moca0511/lapis/pic/lapis.png

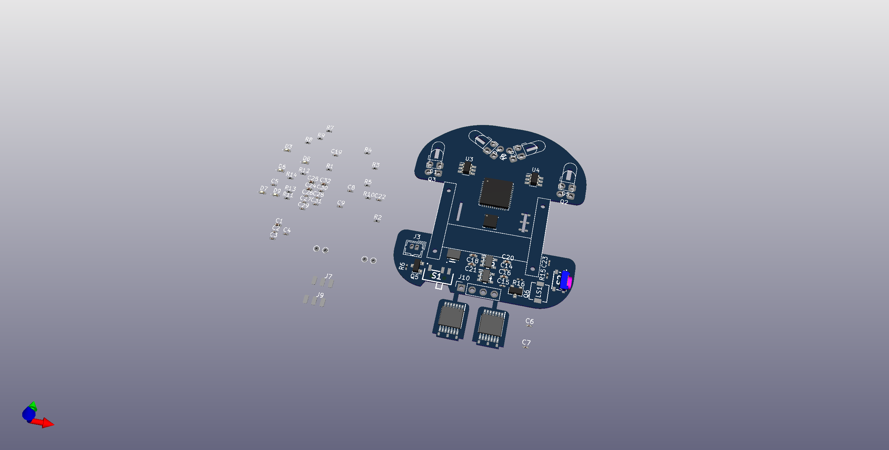
pic/lapis.png
