moca0511/lapis/pcb/lapis/lapis.jpg

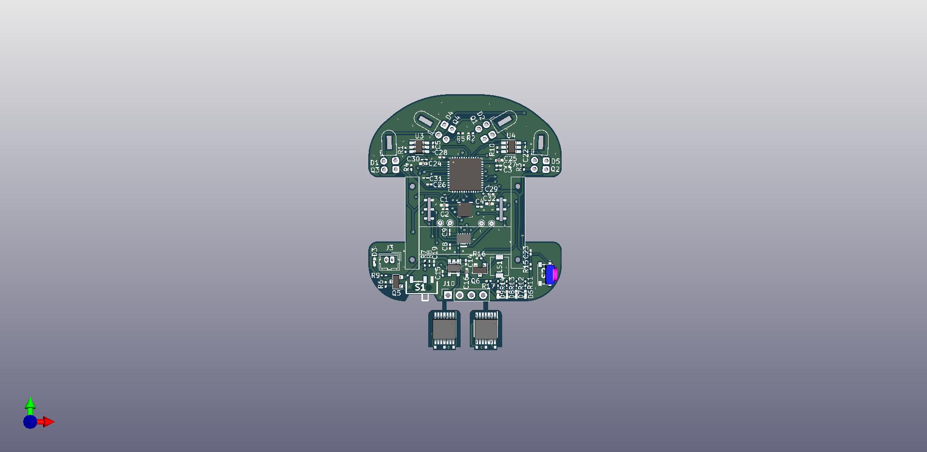
pcb/lapis/lapis.jpg
