moca0511/lapis/pic/3Dprint v1.png

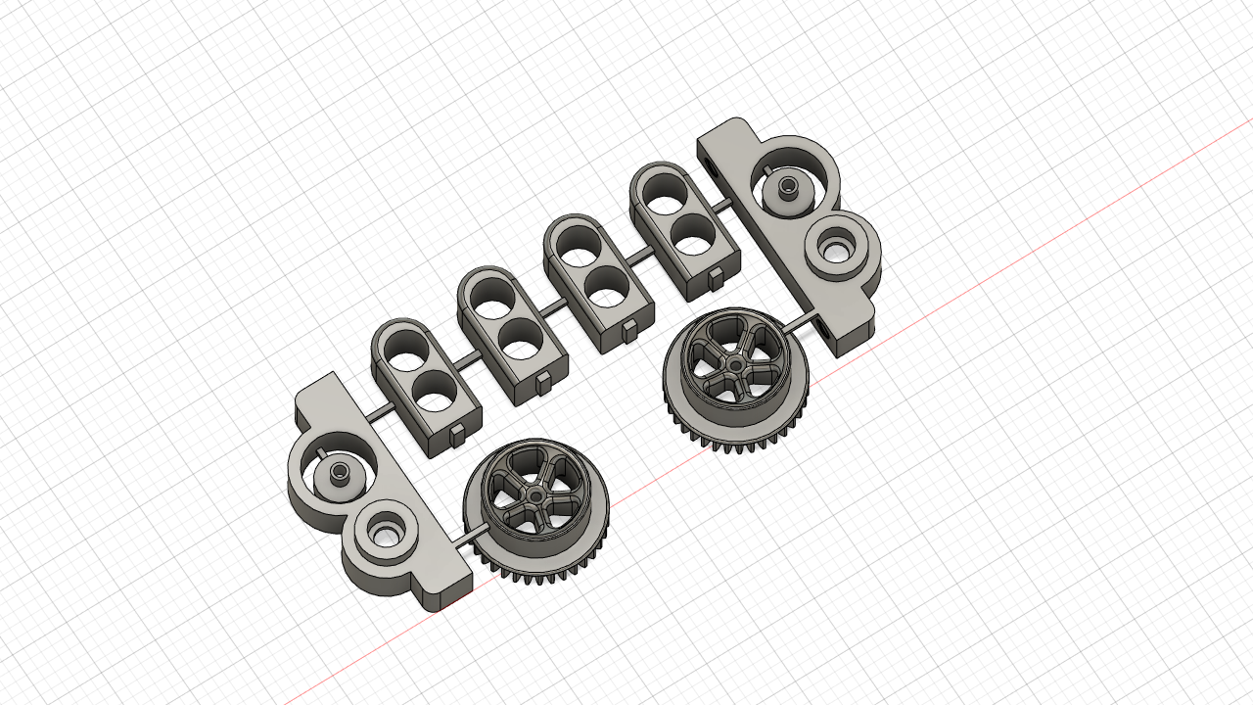
pic/3Dprint v1.png
