moca0511/lapis/pic/lapis v25.png

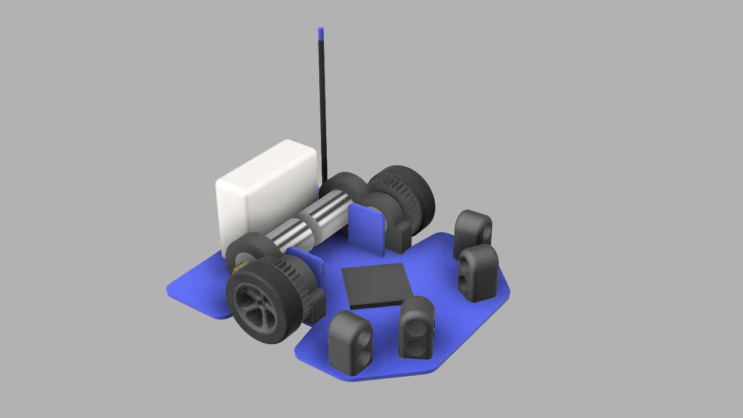
pic/lapis v25.png
