moca0511/lapis/pic/lapis v40.png

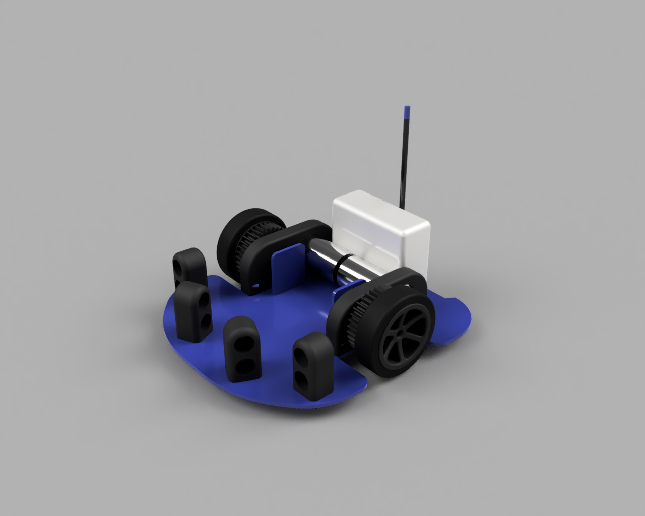
pic/lapis v40.png
