moca0511/lapis/pic/lapis_v30.PNG

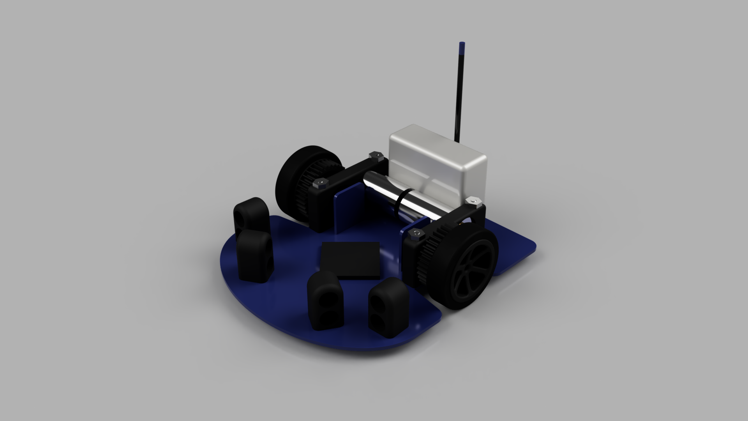
pic/lapis_v30.PNG
