moca0511/lapis/pic/mpu6500.png

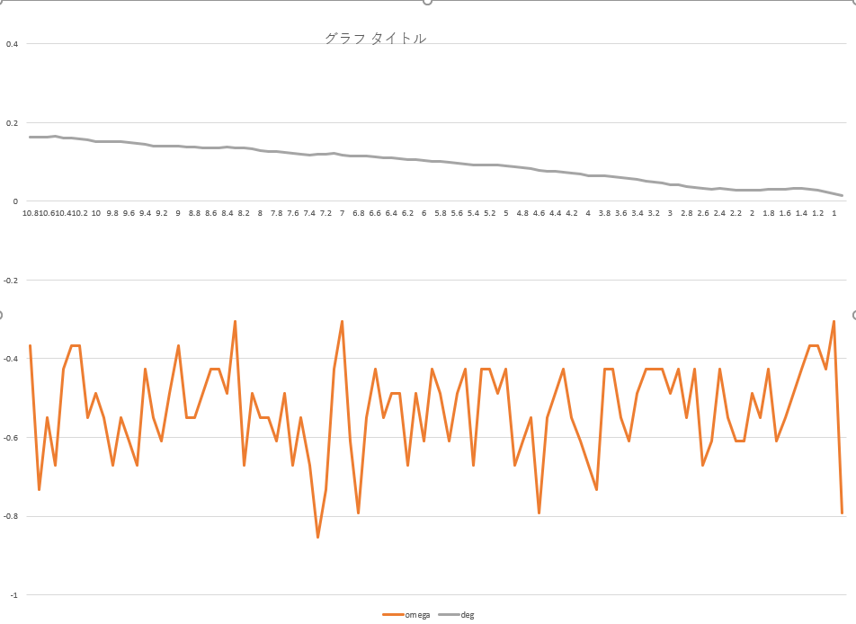
pic/mpu6500.png
