moca0511/lapis/pic/Sirius (v3~recovered).png

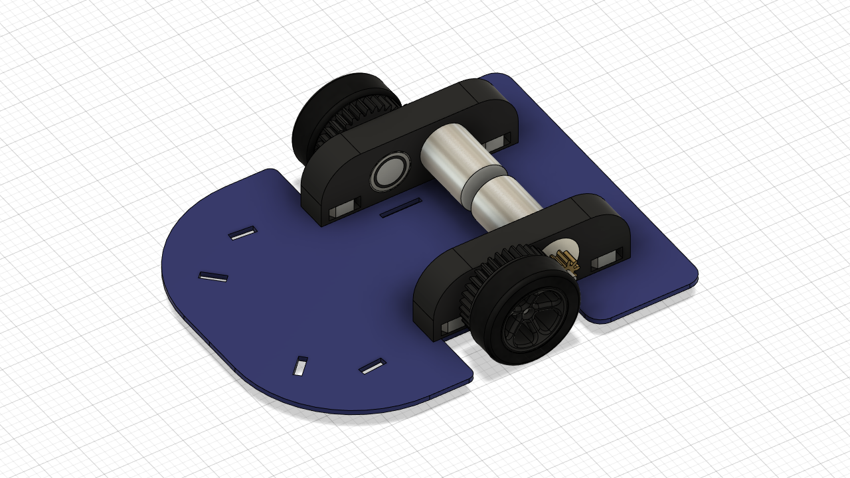
pic/Sirius (v3~recovered).png
