moca0511/lapis/pic/Sirius v7.png

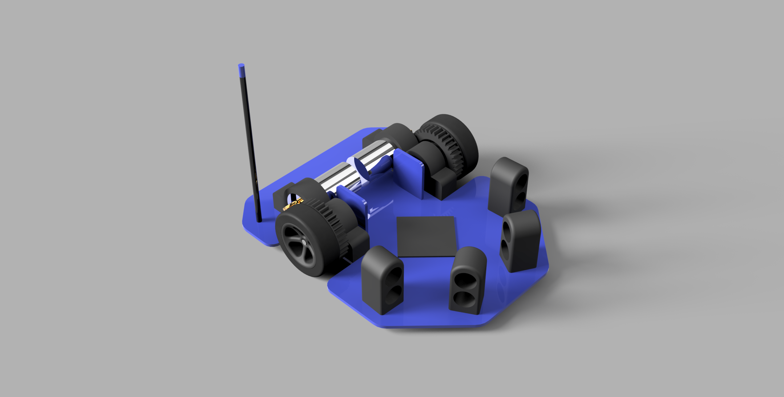
pic/Sirius v7.png
