moca0511/lapis/pic/Sirius v25.png

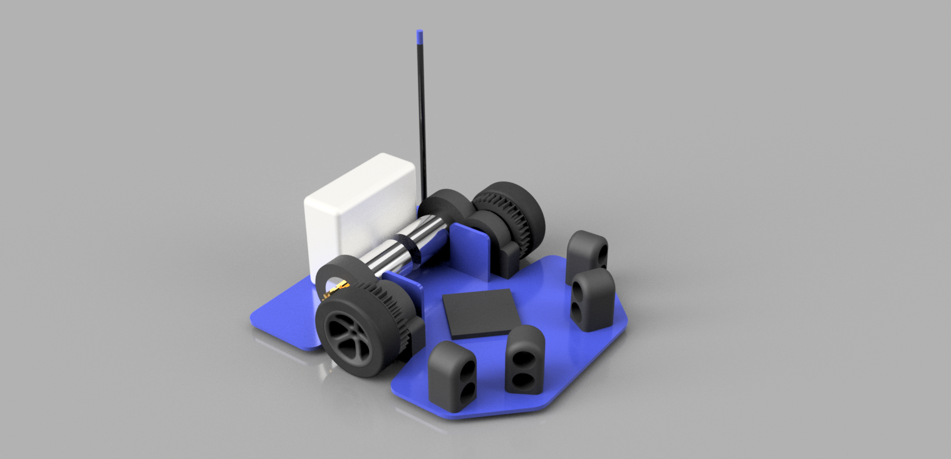
pic/Sirius v25.png
