moca0511/lapis/pic/Sirius v25_torimingu.png

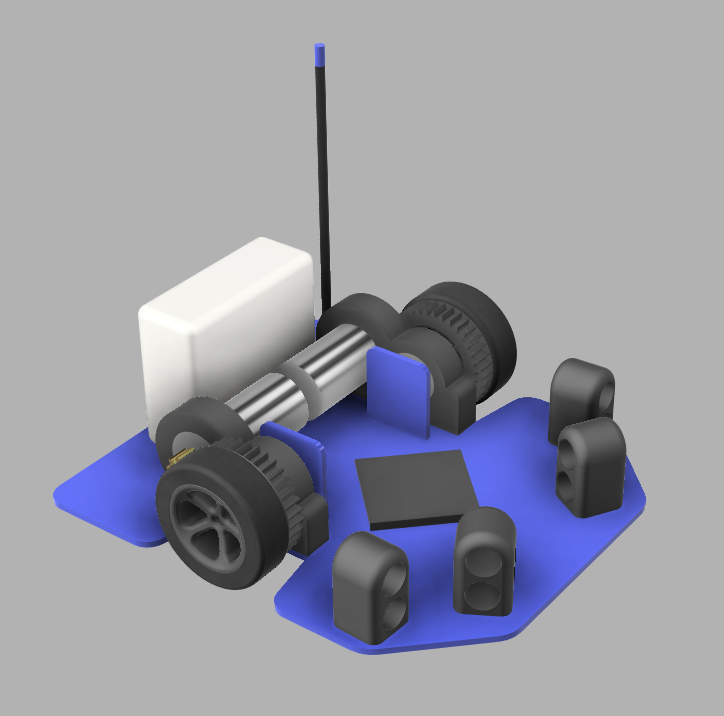
pic/Sirius v25_torimingu.png
