moca0511/lapis/pic/スクリーンショット 2021-02-08 151138.png

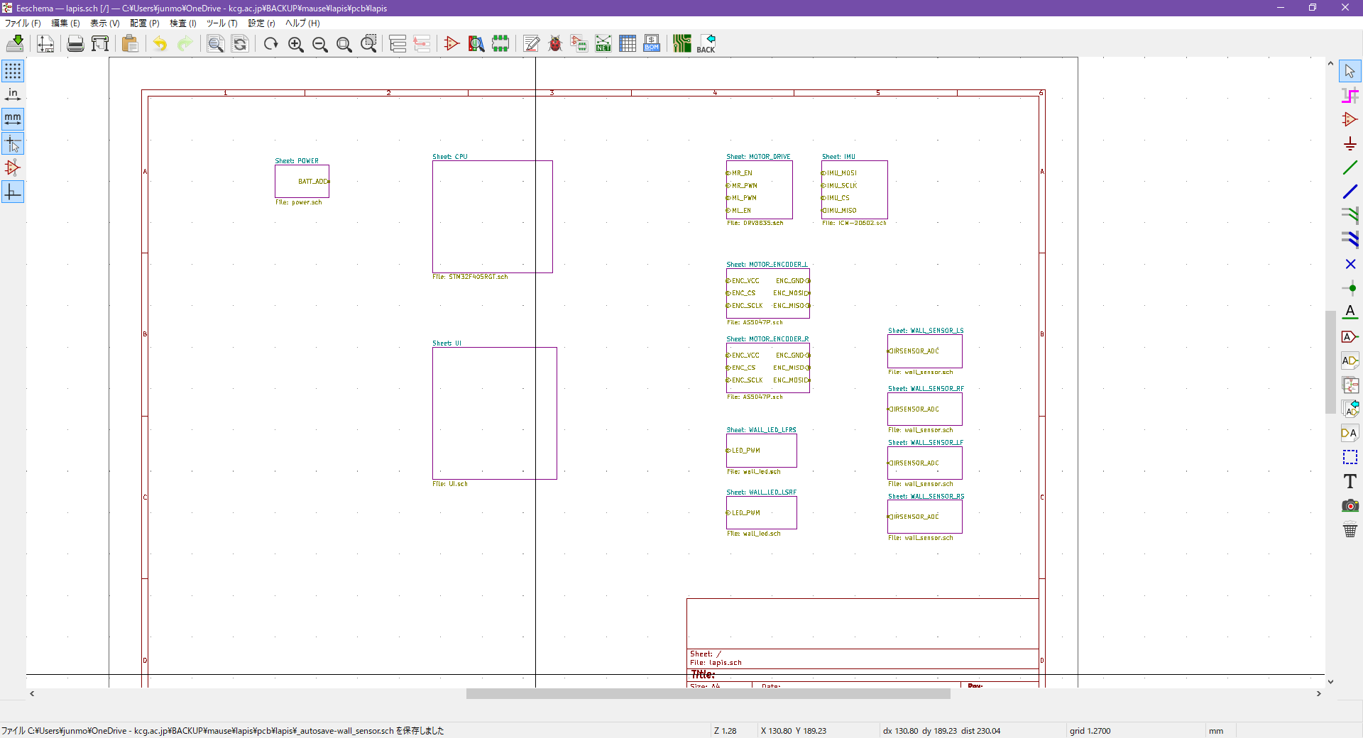
pic/スクリーンショット 2021-02-08 151138.png
