moca0511/lapis/pic/スクリーンショット 2021-06-03 014957.png

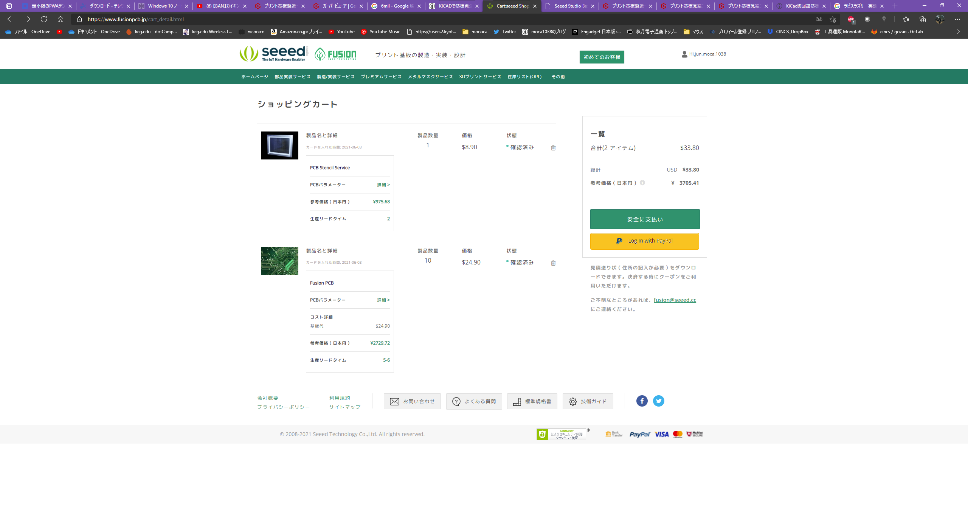
pic/スクリーンショット 2021-06-03 014957.png
