moca0511/lapis/pic/スクリーンショット 2021-11-12 021332.png

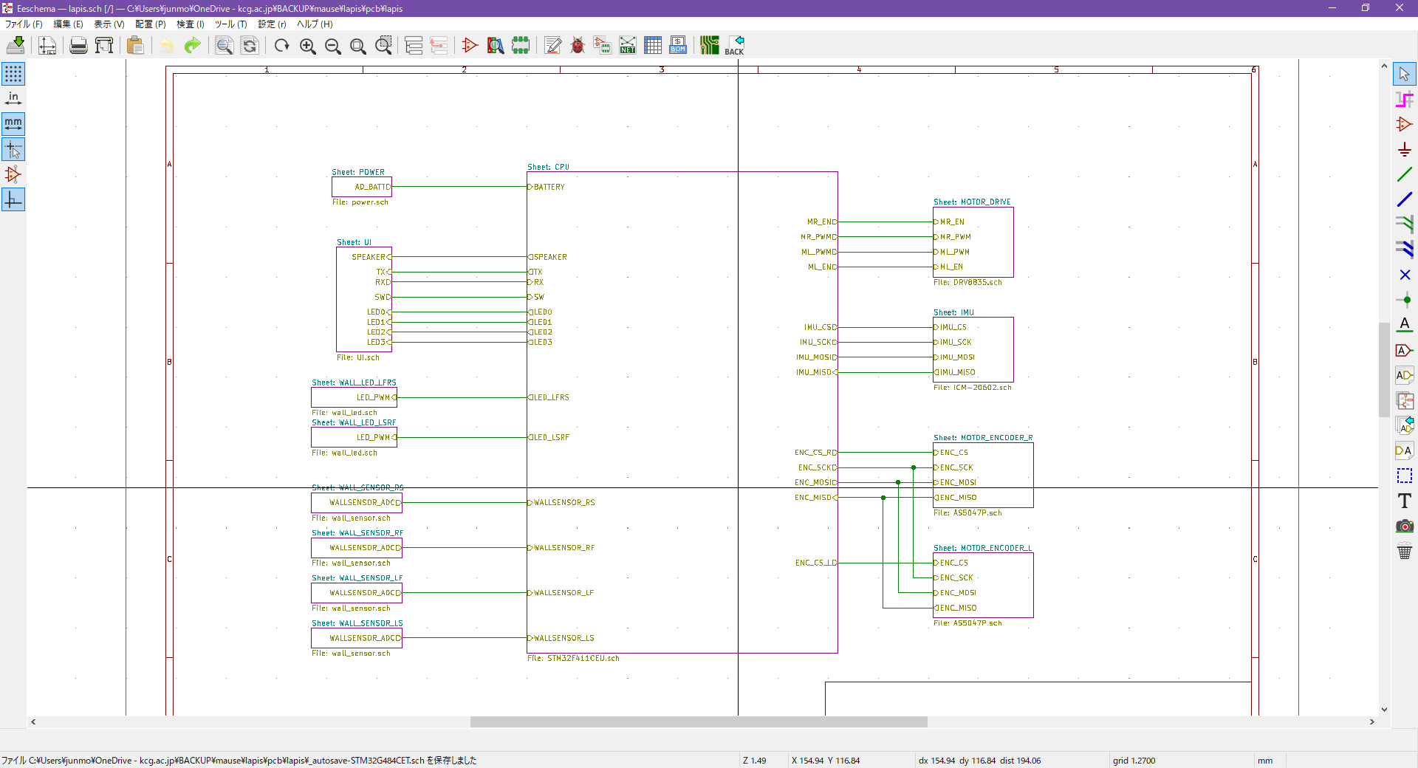
pic/スクリーンショット 2021-11-12 021332.png
