moca0511/lapis/docs/実装リスト.xlsx

> C1, C16 | 2.2u | Capacitor_SMD:C_0402_1005Metric
> C2, C4-C7, C9, C14, C19, C22, C23, C26-C31 | 0.1u | Capacitor_SMD:C_0201_0603Metric
C3 | 0.01u | Capacitor_SMD:C_0201_0603Metric
C8 | 100u | Capacitor_SMD:C_0201_0603Metric
C15 | 470p | Capacitor_SMD:C_0201_0603Metric
> C24, C25, C32 | 10u | Capacitor_SMD:C_0402_1005Metric
> D1, D2, D4, D5 | OSI5FU3A11C | LED_THT:LED_D3.0mm_Horizontal_O1.27mm_Z2.0mm_IRBlack
> D3, D6-D9 | LED | LED_SMD:LED_0402_1005Metric
> IC1, IC2 | AS5047P-ATSM | SOP65P640X120-14N
IC3 | DRV8835DSSR | DRV8835DSSR
IC4 | MIC5219-3.3YM5-TR | SOT95P280X130-5N
> J1, J2, J4-J9 | Conn_01x03 | SamacSys_Parts:ENC_connector
J3 | Conn_01x02 | Connector_Hirose:Hirose_DF13-02P-1.25DSA_1x02_P1.25mm_Vertical
J10 | Conn_01x04 | Connector_PinSocket_2.54mm:PinSocket_1x04_P2.54mm_Vertical
> J11-J14 | Conn_01x01 | TestPoint:TestPoint_THTPad_D1.0mm_Drill0.5mm
LS1 | SMT-0440-S-R | SamacSys_Parts:SMT-0440-S-R
> Q1-Q4 | LTR-4206E | LED_THT:LED_D3.0mm_Horizontal_O1.27mm_Z2.0mm_IRBlack
Q5 | IRLML6402TRPBF | Package_TO_SOT_SMD:SOT-23
Q6 | MMBF0201NLT1G | Package_TO_SOT_SMD:SOT-23
> R1, R10 | 1 | Resistor_SMD:R_0201_0603Metric
> R2-R5, R9, R11-R14 | 1k | Resistor_SMD:R_0201_0603Metric
> R6-R8, R15, R16 | 10k | Resistor_SMD:R_0201_0603Metric
R17 | 100 | Resistor_SMD:R_0201_0603Metric
S1 | SSSS810701 | SSSS810701
S2 | SKRPACE010 | SamacSys_Parts:SMT_4.2X3.2_
U1 | STM32F411CEUx | Package_DFN_QFN:QFN-48-1EP_7x7mm_P0.5mm_EP5.6x5.6mm
U2 | ICM-20602 | Package_LGA:LGA-16_3x3mm_P0.5mm_LayoutBorder3x5y
> U3, U4 | NJU6080 | Package_TO_SOT_SMD:SOT-23-6
