moca0511/lapis/docs/部品リスト.xlsx

 | 2020/06/09更新
発注 | 種類 | 型番 | 価格(税込) | 必要数 | 入数 | 発注数 | 総計 | 発注先 | URL
✓ | lipo | 100 mAh 3.7 V 20C | ¥887.73 | 1 | 10 | 1 | ¥887.73 | AliExpress | https://ja.aliexpress.com/item/32949582665.html?spm=a2g0o.cart.0.0.7cdc3c00jKSDOY&mp=1
✓ | M1.4低頭ねじ | FX-1425EB | ¥400 | 4 | 100 | 1 | ¥400 | wilco | https://wilco.jp/products/F/FX-EB.html#page1
✓ | 鉄スペーサ | スペーサー(鉄/三価ホワイト)4×5.3×2 | ¥439 | 2 | 50 | 1 | ¥439 | モノタロウ | https://www.monotaro.com/p/4226/4923/
✓ | ベアリング | DDL-310 | ¥428 | 4 | 1 | 8 | ¥3424 | モノタロウ | https://www.monotaro.com/p/0953/8094/
✓ | シャフト | 平行ピン 硬質(ステンレス)(パック品)1φmm×6mm | ¥439 | 2 | 17 | 1 | ¥439 | モノタロウ | https://www.monotaro.com/p/4220/4741/
✓ | ピニオンギヤ | RT-PN(m0.3 T9 2mm) | ¥880 | 2 | 2 | 2 | ¥1760 | RT ROBOT SHOP | https://www.rt-shop.jp/index.php?main_page=product_info&products_id=2984
✓ | タイヤ | RT-MM_TIRE10_10 | ¥2200 | 2 | 10 | 1 | ¥2200 | RT ROBOT SHOP | https://www.rt-shop.jp/index.php?main_page=product_info&products_id=3642
✓ | DCモータ | MK06-4.5 | ¥1100 | 2 | 2 | 2 | ¥2200 | RT ROBOT SHOP | https://www.rt-shop.jp/index.php?main_page=product_info&products_id=1254
✓ | 磁石
✓ | CPU | STM32F405RGT6TR | ¥1201 | 1 | 1 | 2 | ¥2402 | mauser | https://www.mouser.jp/ProductDetail/STMicroelectronics/STM32F405RGT6TR?qs=MavH1QghrkHshpR6GkvPIg%3D%3D
✓ | IMU | ICM-20602 | ¥366 | 1 | 1 | 2 | ¥732 | mauser | https://www.mouser.jp/ProductDetail/TDK/ICM-20602/?qs=u4fy%2FsgLU9NtDChFbqTxBA%3D%3D
✓ | 磁気エンコーダ | AS5047P-ATSM | ¥1339 | 2 | 1 | 4 | ¥5356 | mauser | https://www.mouser.jp/ProductDetail/ams/AS5047P-ATSM?qs=cGEy3R83DS8fzNOVLHtOgg%3D%3D
✓ | モータドライバ | DRV8835DSSR | ¥166 | 1 | 1 | 2 | ¥332 | mauser | https://www.mouser.jp/ProductDetail/Texas-Instruments/DRV8835DSSR?qs=UFc95S4Z4CYjBOyEmbTDlA%3D%3D
✓ | IRLED | OSI5FU3A11C | ¥200 | 4 | 10 | 1 | ¥200 | 秋月 | https://akizukidenshi.com/catalog/g/gI-04313/
✓ | 定電流LEDドライバ | NJU6080F1 | ¥65 | 2 | 1 | 4 | ¥260 | 秋月 | https://akizukidenshi.com/catalog/g/gI-14719/
✓ | フォトトランジスタ | LTR-4206E | ¥19 | 4 | 1 | 8 | ¥152 | mauser | https://www.mouser.jp/ProductDetail/Lite-On/LTR-4206E?qs=GHV6gLndNKlNoc%252Btn97dSA==
✓ | 3.3Vレギュレータ | MIC5219-3.3YM5-TR | ¥100 | 1 | 1 | 2 | ¥200 | mauser | https://www.mouser.jp/ProductDetail/Microchip-Technology-Micrel/MIC5219-33YM5-TR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
✓ | 3.3Vリファレンス | REF1933AIDDCT | ¥299 | 1 | 1 | 2 | ¥598 | mauser | https://www.mouser.jp/ProductDetail/Texas-Instruments/REF1933AIDDCT?qs=asCBFxFfL1SYqn%2FsVpk0PQ%3D%3D
✓ | PchMOSFET | IRLML6402TRPBF | ¥53 | 1 | 1 | 4 | ¥212 | mauser | https://www.mouser.jp/ProductDetail/Infineon-IR/IRLML6402TRPBF?qs=9%252BKlkBgLFf0HuZuONx2Ewg%3D%3D
✓ | NchMOSFET | MMBF0201NLT1G | ¥45 | 5 | 1 | 10 | ¥450 | mauser | https://www.mouser.jp/ProductDetail/ON-Semiconductor/MMBF0201NLT1G?qs=HVbQlW5zcXV7kxGsyqwNew%3D%3D
✓ | スピーカー | SMT-0440-S-R | ¥389 | 1 | 1 | 2 | ¥778 | mauser | https://www.mouser.jp/ProductDetail/PUI-Audio/SMT-0440-S-R?qs=7PCaVhlmG1oowtjqzAyJ8A%3D%3D
✓ | スライドスイッチ | SSSS810701 | ¥108 | 1 | 1 | 2 | ¥216 | mauser | https://www.mouser.jp/ProductDetail/Alps-Alpine/SSSS810701
✓ | タクトスイッチ | TVAF06-A020B-R | ¥110 | 1 | 5 | 1 | ¥110 | 秋月 | https://akizukidenshi.com/catalog/g/gP-14888/
✓ | UILED | nobrand | ¥96 | 6 | 100 | 1 | ¥96 | AliExpress | https://ja.aliexpress.com/item/32288211535.html?spm=a2g0o.cart.0.0.3ac83c00LpDg8D&mp=1
✓ | チップ抵抗 | 0805 1/4W各種 | ¥60 | x | 100 | 9 | ¥540 | AliExpress | https://ja.aliexpress.com/item/4000049692396.html?spm=a2g0o.cart.0.0.6b6a3c00ORcdYP&mp=1
✓ | チップコンデンサ | 0805 各種 | ¥80 | x | 100 | 7 | ¥560 | AliExpress | https://ja.aliexpress.com/item/33052605909.html?spm=a2g0o.cart.0.0.79553c001Huzwk&mp=1
 | 3Dプリント部品各種 | ナイロン | ¥1436 | 1 | 1 | 1 | ¥1436 | DMM.make | https://make.dmm.com/
 | 総金額 |  |  |  |  |  | ¥26379.73
 | 要金額 |  |  |  |  |  | ¥26379.73
