moca0511/lapis/3Dmodel/LED_hold.stl

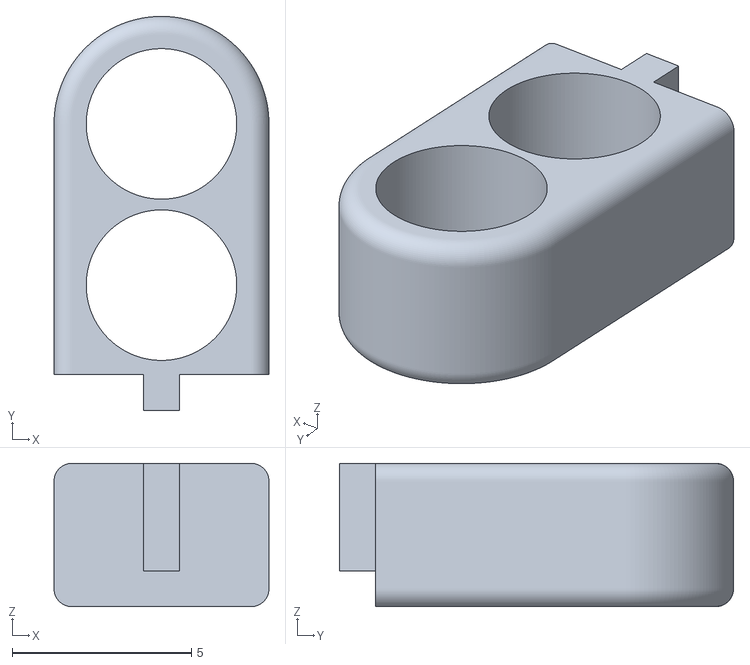
[picture p15: CAD file, 2022-03-08]
3Dmodel/LED_hold.stl
6.00 x 11.0 x 4.00
