moca0511/lapis/pcb/lapis/lapis_pcb.dxf

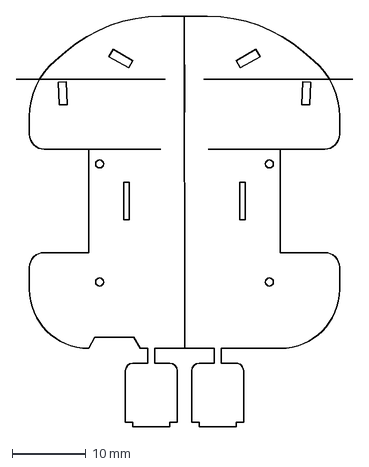
[picture p16: CAD file, 2021-06-30]
pcb/lapis/lapis_pcb.dxf
45.6 x 55.6 mm
