moca0511/lapis/3Dmodel/LED_mount.stl

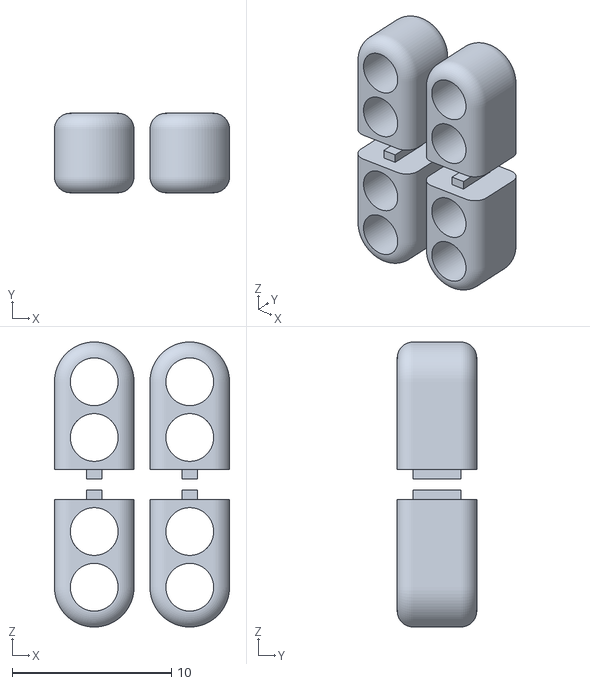
[picture p17: CAD file, 2021-06-30]
3Dmodel/LED_mount.stl
11.0 x 5.00 x 17.9
