moca0511/lapis/pcb/lapis/lapis.step

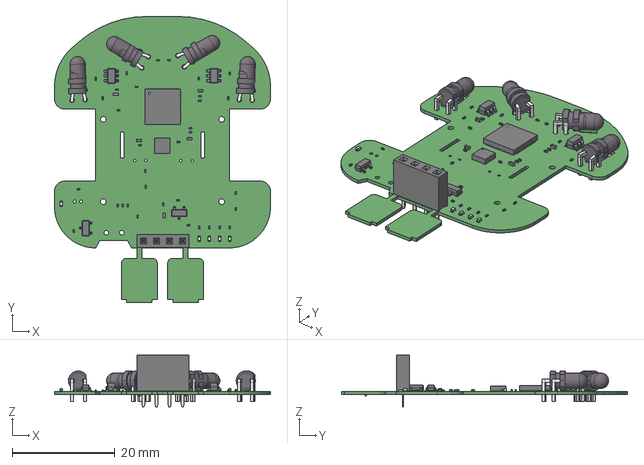
[picture p18: CAD file, 2021-06-30]
pcb/lapis/lapis.step
42.0 x 55.6 x 10.1 mm
