moca0511/lapis/3Dmodel/gearW2.stl

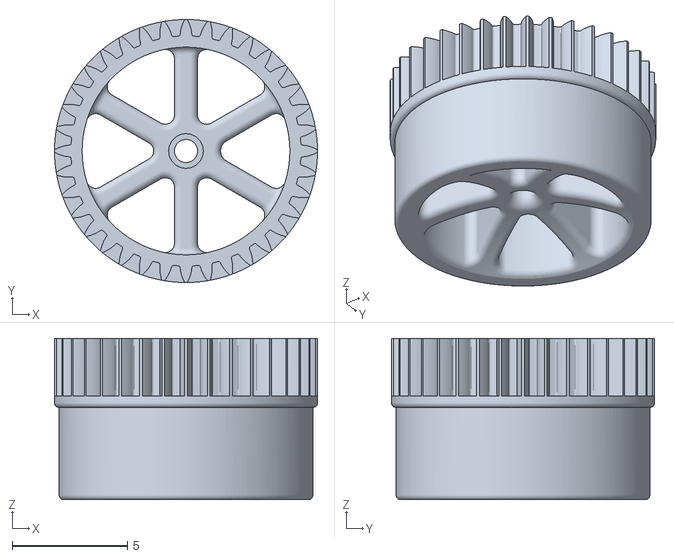
[picture p19: CAD file, 2021-06-30]
3Dmodel/gearW2.stl
11.4 x 11.4 x 7.00
