moca0511/lapis/3Dmodel/lapis_v1.stl

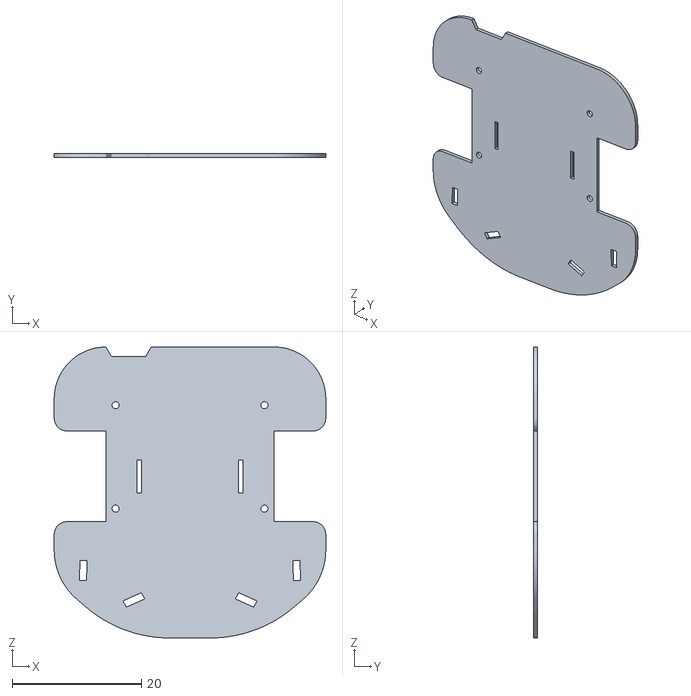
[picture p20: CAD file, 2021-06-30]
3Dmodel/lapis_v1.stl
42.0 x 0.6 x 45.0
