moca0511/lapis/3Dmodel/mk06.stl

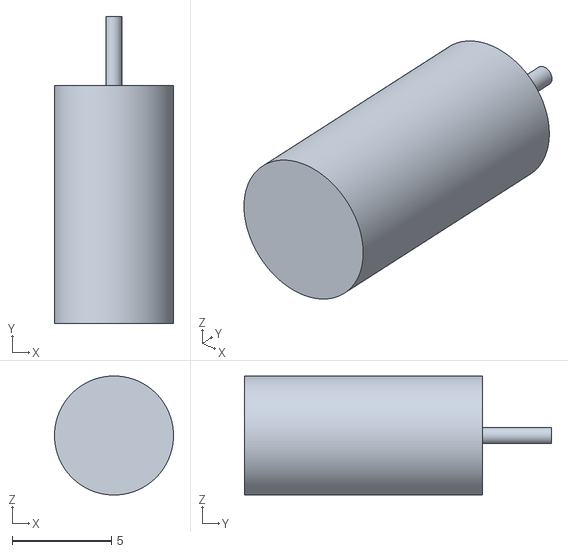
[picture p21: CAD file, 2020-11-08]
3Dmodel/mk06.stl
6.00 x 15.5 x 6.00
