moca0511/lapis/3Dmodel/pcb.stl

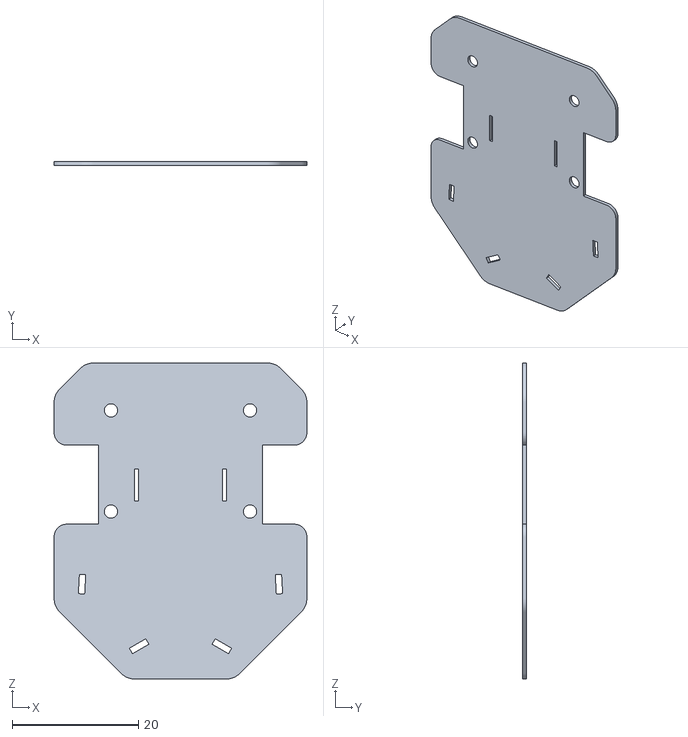
[picture p22: CAD file, 2020-11-08]
3Dmodel/pcb.stl
40.0 x 0.6 x 50.0
