moca0511/lapis/3Dmodel/MOR.stl

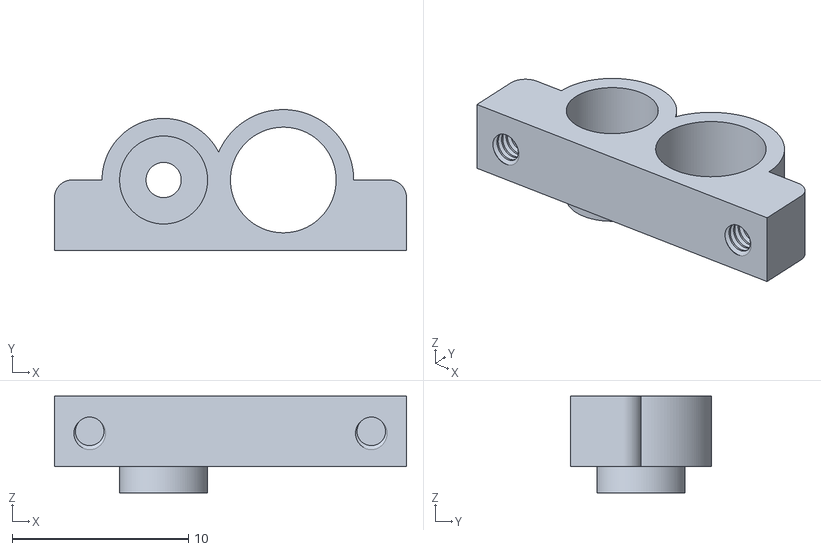
[picture p23: CAD file, 2020-11-08]
3Dmodel/MOR.stl
20.0 x 8.00 x 5.50
