moca0511/lapis/3Dmodel/tire.stl

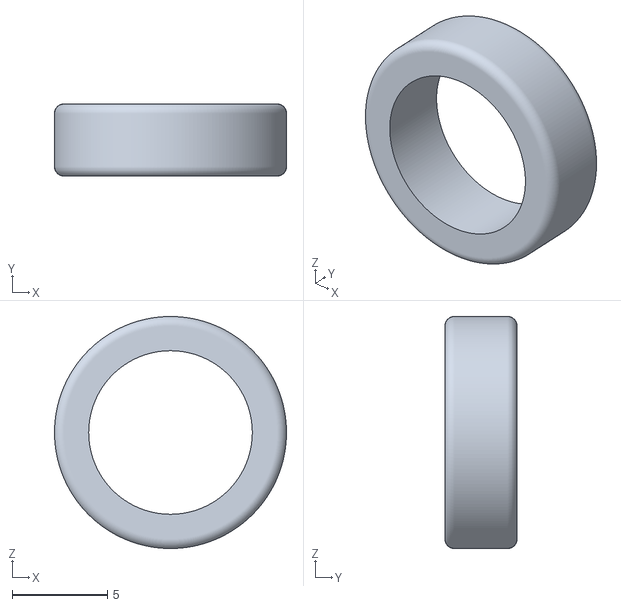
[picture p24: CAD file, 2020-11-08]
3Dmodel/tire.stl
12.2 x 3.80 x 12.2
