moca0511/lapis/3Dmodel/mghold.stl

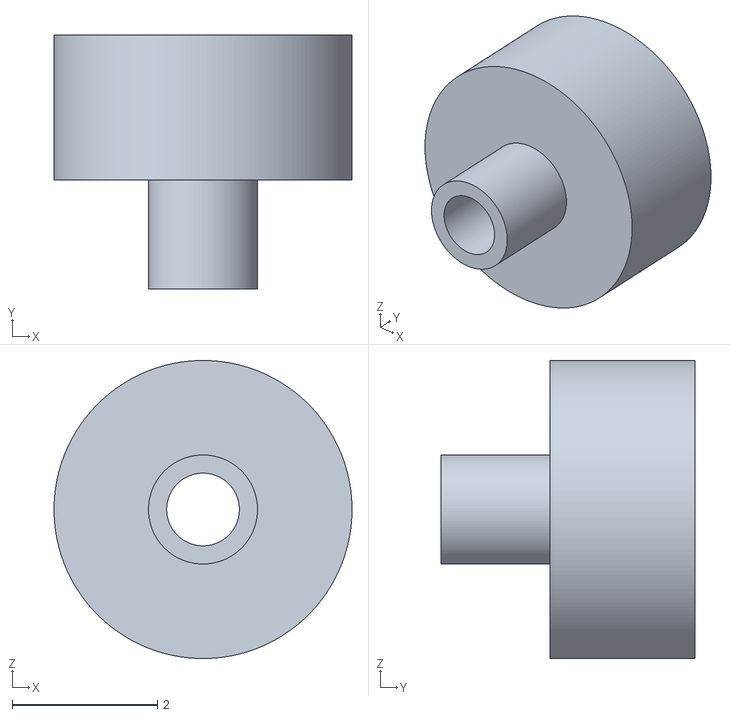
[picture p25: CAD file, 2020-11-08]
3Dmodel/mghold.stl
4.10 x 3.50 x 4.10
