moca0511/lapis/3Dmodel/gearW.stl

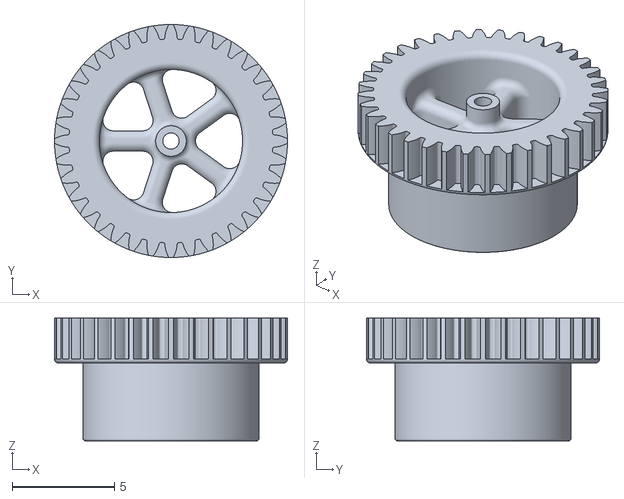
[picture p26: CAD file, 2020-11-08]
3Dmodel/gearW.stl
11.4 x 11.4 x 6.00
