moca0511/lapis/(list of files, cad)

Other CAD files:
3Dmodel/MOL.stl
pcb/lapis/pcb v3.ipt
