moca0511/lapis/(list of files, drawings)

Other design files:
pcb/lapis/lapis.dsn
