moca0511/lapis/firm2/lapis/lapis.ioc

Mcu.UserName=STM32G484CETx
PA0.GPIO_Label=WALL_RS
PA0.Signal=ADC1_IN1
PA1.GPIO_Label=WALL_RF
PA1.Signal=ADC1_IN2
PA10.GPIO_Label=ENC_MISO
PA10.Signal=SPI2_MISO
PA11.GPIO_Label=MR_EN
PA11.Signal=S_TIM4_CH1
PA12.GPIO_Label=ML_EN
PA12.Signal=S_TIM4_CH2
PA13.Signal=SYS_JTMS-SWDIO
PA14.Signal=SYS_JTCK-SWCLK
PA2.GPIO_Label=WALL_LF
PA2.Signal=ADC1_IN3
PA3.GPIO_Label=WALL_LS
PA3.Signal=ADC1_IN4
PA4.GPIO_Label=ENC_CS_L
PA4.Signal=GPIO_Output
PA5.GPIO_Label=IMU_SCK
PA5.Signal=SPI1_SCK
PA6.GPIO_Label=IMU_MISO
PA6.Signal=SPI1_MISO
PA7.GPIO_Label=IMU_MOSI
PA7.Signal=SPI1_MOSI
PA8.GPIO_Label=ENC_CS_R
PA8.Signal=GPIO_Output
PA9.Signal=USART1_TX
PB0.GPIO_Label=IMU_CS
PB0.Signal=GPIO_Output
PB1.GPIO_Label=ML_PHASE
PB1.Signal=GPIO_Output
PB11.GPIO_Label=BUZZER
PB11.Signal=S_TIM2_CH4
PB14.GPIO_Label=BATTERY
PB14.Signal=ADC1_IN5
PB15.GPIO_Label=ENC_MOSI
PB15.Signal=SPI2_MOSI
PB2.GPIO_Label=MR_PHASE
PB2.Signal=GPIO_Output
PB4.GPIO_Label=LED_LSRF
PB4.Signal=GPIO_Output
PB5.GPIO_Label=LED_LFRS
PB5.Signal=GPIO_Output
PB7.Signal=USART1_RX
PB9.GPIO_Label=SW
PB9.Signal=GPIO_Input
PC13.GPIO_Label=LED1
PC13.Signal=GPIO_Output
PC14-OSC32_IN.GPIO_Label=LED2
PC14-OSC32_IN.Signal=GPIO_Output
PC15-OSC32_OUT.GPIO_Label=LED3
PC15-OSC32_OUT.Signal=GPIO_Output
PF0-OSC_IN.GPIO_Label=LED4
PF0-OSC_IN.Signal=GPIO_Output
PF1-OSC_OUT.GPIO_Label=ENC_SCK
PF1-OSC_OUT.Signal=SPI2_SCK
