moca0511/lapis/firm2/lapis/Core/Inc/maze.h

/*
 * maze.h
 *
 *  Created on: Sep 5, 2020
 *      Author: junmo
 */

#ifndef INC_MAZE_H_
#define INC_MAZE_H_
#include"main.h"
#include"lapis.h"

#define MAP_X_MAX (16)
#define MAP_Y_MAX (16)
#define MAP_SIZE	(MAP_X_MAX*MAP_Y_MAX)	//　マップマスの数
#define GOAL_X (3)
#define GOAL_Y (3)
#define START_X (0)
#define START_Y (0)
#define GOAL (GOAL_Y * MAP_X_MAX + GOAL_X) //ｓゴールの添え字
#define START (START_Y * MAP_Y_MAX + START_X)	//ｓスタートの添え字

typedef enum {
	NORTH,
	EAST,
	SOUTH,
	WEST
} COMPASS_POINT;

typedef struct MAP {
	uint8_t step;	//ゴールまでの距離
	uint8_t wall;	//北東南西北東南西　上位4bit:探索確認(1:探索済み　0:未探索)　下位4bit:壁の有無(1:壁あり0:壁なし)
	t_bool check;
} MAP;

void smap_Init(void);  // 歩数マップ初期化
void make_smap(uint16_t gx, uint16_t gy, uint8_t mode); //	gx,gyを目標値とした歩数を設定
void print_map(void);	//	歩数マップ表示
void wall_set(uint8_t mode);//壁情報取得
void wall_set_around(void);//壁情報を周囲のマスに反映
uint8_t wall_check(uint8_t direction);//指定方向に壁があるか確認
int16_t step_check(uint16_t posX, uint16_t posY, uint8_t direction);//指定位置と指定方向の隣接マスの歩数の差を返す
void check_searchBlock(uint16_t *searchX,uint16_t *searchY);//未探索かつ最短歩数ルートの可能性のあるマスの座標確認
void maze_save(void);//迷路情報保存
void maze_load(void);//迷路情報読み出し
void chenge_pos(int16_t block, int16_t *temp_posX, int16_t *temp_posY,
		int8_t temp_head);
void chenge_head(uint16_t direction, uint32_t value, int8_t *head_buf);
t_bool get_unknow_block(uint16_t *x, uint16_t *y);


#endif /* INC_MAZE_H_ */
