moca0511/lapis/firm2/lapis/Core/Inc/AS5047P.h

/*
 * AS5047P.h
 *
 *  Created on: Jun 18, 2021
 *      Author: junmo
 */

#ifndef INC_AS5047P_H_
#define INC_AS5047P_H_

#include"main.h"
#include"lapis.h"

typedef struct
{
	SPI_HandleTypeDef *hspin;

	GPIO_TypeDef *CSNport;
	uint16_t CSNpin;
}AS5047_TypeDef;

typedef enum {
	ENC_R,
	ENC_L
} ENC_SELECT;

typedef enum {
	AS5047_ROTATE_FORWERD,
	AS5047_ROTATE_REVERCE,
	AS5047_ROTATE_NON
} ENC_DIRECTION;


//spi command frame 格式
#define AS5047_COMMAND_READ 0x4000




//Volatil Registers 的 addrees mapping
#define	NOP_AS5047P_VOL_REG_ADD 0x0000
#define ERRFL_AS5047P_VOL_REG_ADD 0x0001
#define PROG_AS5047P_VOL_REG_ADD 0x0003
#define DIAAGC_AS5047P_VOL_REG_ADD 0x3ffc
#define MAG_AS5047P_VOL_REG_ADD 0x3ffd
#define ANGLEUNC_AS5047P_VOL_REG_ADD 0x3ffe
#define ANGLECOM_AS5047P_VOL_REG_ADD 0x3fff

//non-volatile-registers 的 addrees mapping
#define ZPOSM_AS5047P_nVOL_REG_ADD 0x0016
#define ZPOSL_AS5047P_nVOL_REG_ADD 0x0017
#define SETTINGS1_AS5047P_nVOL_REG_ADD 0x0018
#define SETTINGS2_AS5047P_nVOL_REG_ADD 0x0019
#define RED_AS5047P_VOL_nREG_ADD 0x001a




//------------------------------------------------






void AS5047_Init(void);
void AS5047_SetZeroPosition(int devidx);
uint16_t AS5047_Get_ZeroPosition(int devidx);
uint16_t AS5047_Get_ERRFL(int devidx);
uint16_t AS5047_WriteData(int devidx,uint16_t addr,uint16_t data);
uint16_t AS5047_ReadData(int devidx,uint16_t addr);
float AS5047_ReloadAngle(int devidx);
float AS5047_GetAngle(int devidx);
int8_t AS5047_GetDirection(int devidx, float angle_prev);
float AS5047_GetSpeed(int devidx, float angle_prev);

#endif /* INC_AS5047P_H_ */
