moca0511/lapis/firm2/lapis/Core/Inc/flash.h

/*
 * flash.h
 *
 *  Created on: 2020/10/07
 *      Author: junmo
 */

#include"main.h"
#ifndef INC_FLASH_H_
#define INC_FLASH_H_

#define MAZE_FLASH_START_ADD 0x0803F800   //sentor1 start address
#define MAZE_FLASH_END_ADD 0x0803FFFF // sector1 end address

void eraseFlash( void );//sentor1全消去
void writeFlash(uint32_t address, uint64_t *data, uint32_t size  );//flashの指定addressからdataの内容をsize分書き込み
void loadFlash(uint32_t address, uint8_t *data, uint32_t size );

#endif /* INC_FLUSH_H_ */
