moca0511/lapis/firm2/lapis/Core/Src/adc.c

/*
 * adc.c
 *
 *  Created on: Jun 14, 2021
 *      Author: junmo
 */

#include "adc.h"
#include "uart.h"
#include"main.h"
static uint16_t aADCxConvertedData[5];

uint16_t get_adc(uint8_t channel) {
	return aADCxConvertedData[channel];
}

void adc_dma_start(void) {
	if (HAL_ADC_Start_DMA(&hadc1, (uint32_t*) aADCxConvertedData, 5)
			== HAL_OK) {
		printf("Start ADC Successfully\n\r");
		printf("%d,%d,%d,%d,%d\n", aADCxConvertedData[0], aADCxConvertedData[1],
				aADCxConvertedData[2], aADCxConvertedData[3],
				aADCxConvertedData[4]);
	} else {
		printf("Start ADC failed\n\r");
	}
}
