moca0511/lapis/(commit log)

2021-06-30 基板修正途中 ソフト動作確認まで
    [AS5047P.sch, DRV8835.sch, ICM-20602.sch, LED_hold.stl, LED_mount.stl, STM32F405RGT.sch, STM32F411CEU.sch, UI.sch]
2021-11-11 STM411失敗基板 STM484に変更し基板修正
    [AS5047P.sch, STM32F411CEU.sch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]
2022-03-08 信地旋回探索
    [AS5047P.sch, DRV8835.sch, ICM-20602.sch, LED_hold.stl, STM32G484CET.sch, UI.sch, cincs_mouse.kicad_pcb, cincs_mouse.sch]
2022-03-08 走行距離・速度推定改良 スラローム無しでの探索＆最短
2022-03-08 firmware消去
2022-03-10 ディレクトリ変更
2022-03-10 スラ探索・v90二次走行
2022-03-14 22年全日本プログラム
2022-05-18 PC切り替え Kicadv6に変更
    [AS5047P.kicad_sch, DRV8835.kicad_sch, ICM-20602.kicad_sch, STM32G484CET.kicad_sch, UI.kicad_sch, com_board.kicad_sch, lapis.kicad_pcb, lapis.kicad_sch]
